akuker/NetworkBreaker/README.md

# NetworkBreaker
Simple USB device for physically breaking/switching Ethernet signals programatically
