akuker/NetworkBreaker/Case/Case.FCStd

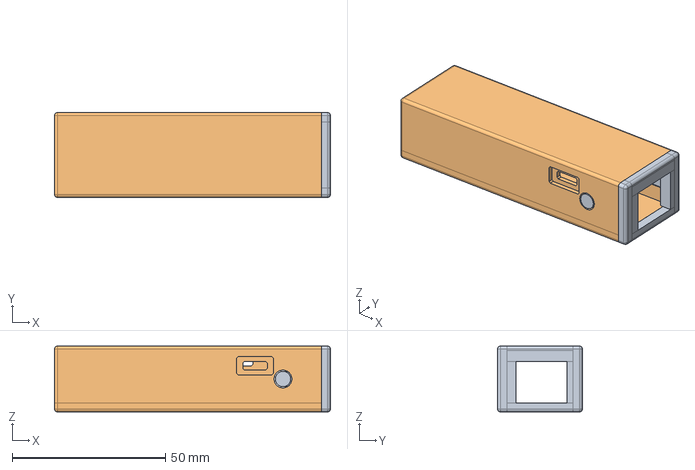
[picture p1: CAD file, 2020-10-17]
Case/Case.FCStd
90.0 x 27.6 x 21.5 mm
