akuker/NetworkBreaker/hw/v1p0/NetworkBreaker_sch.pdf

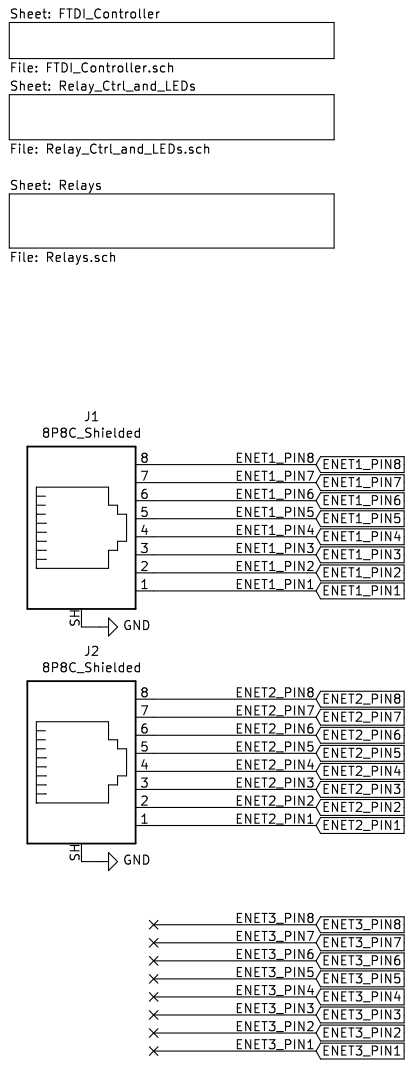
[picture p7: page 1]

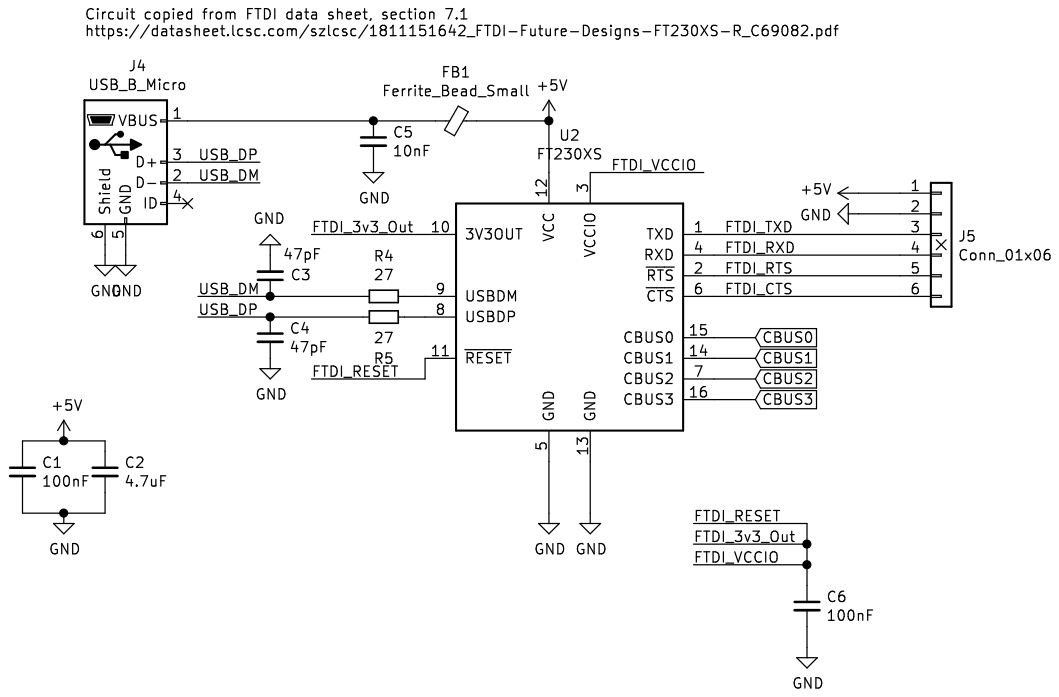
[picture p8: page 2]

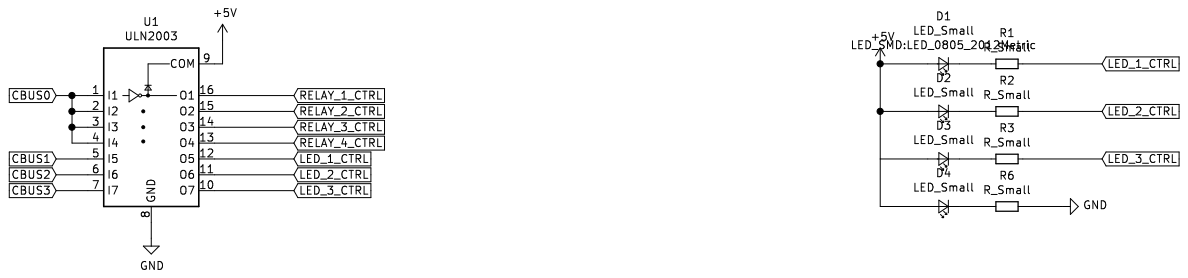
[picture p9: page 3]
