akuker/NetworkBreaker/hw/v1p0/NetworkBreaker.kicad_pcb

## KiCad design hw/v1p0/NetworkBreaker.kicad_pcb (2020-09-26)

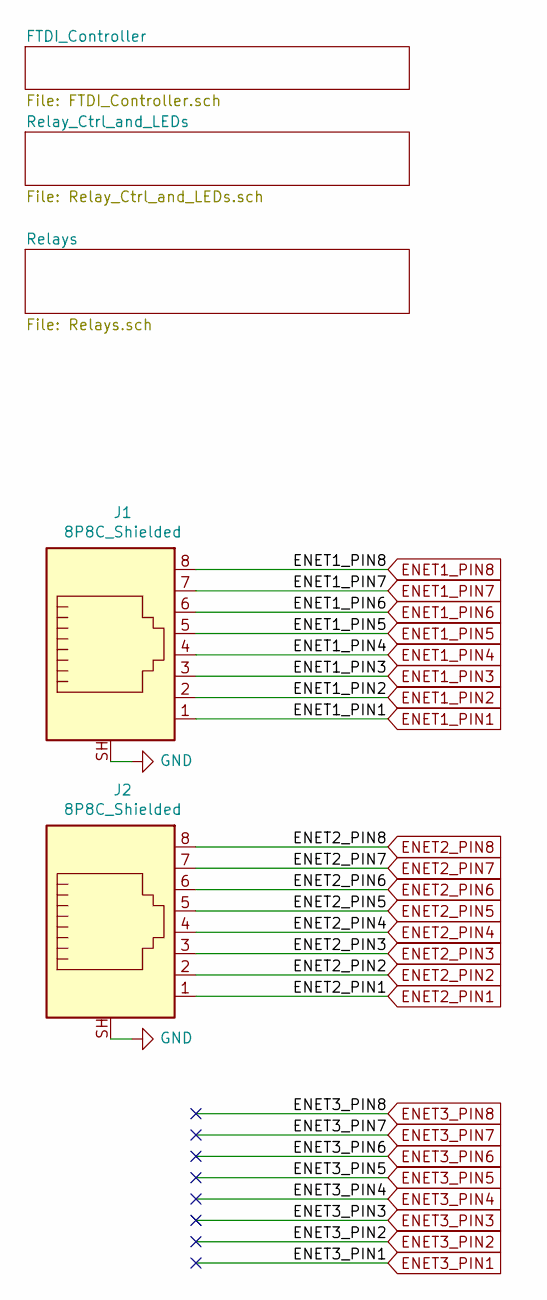
[picture p10: schematic NetworkBreaker.sch]

Parts:
J1, J2: 8P8C_Shielded; RJ45_Amphenol_RJHSE5380; LCSC C86575

Connections:
ENET1_PIN1: J1.1; also elsewhere on the board
ENET1_PIN2: J1.2; also elsewhere on the board
ENET1_PIN3: J1.3; also elsewhere on the board
ENET1_PIN4: J1.4; also elsewhere on the board
ENET1_PIN5: J1.5; also elsewhere on the board
ENET1_PIN6: J1.6; also elsewhere on the board
ENET1_PIN7: J1.7; also elsewhere on the board
ENET1_PIN8: J1.8; also elsewhere on the board
ENET2_PIN1: J2.1; also elsewhere on the board
ENET2_PIN2: J2.2; also elsewhere on the board
ENET2_PIN3: J2.3; also elsewhere on the board
ENET2_PIN4: J2.4; also elsewhere on the board
ENET2_PIN5: J2.5; also elsewhere on the board
ENET2_PIN6: J2.6; also elsewhere on the board
ENET2_PIN7: J2.7; also elsewhere on the board
ENET2_PIN8: J2.8; also elsewhere on the board
GND: J1.SH, J2.SH; also elsewhere on the board

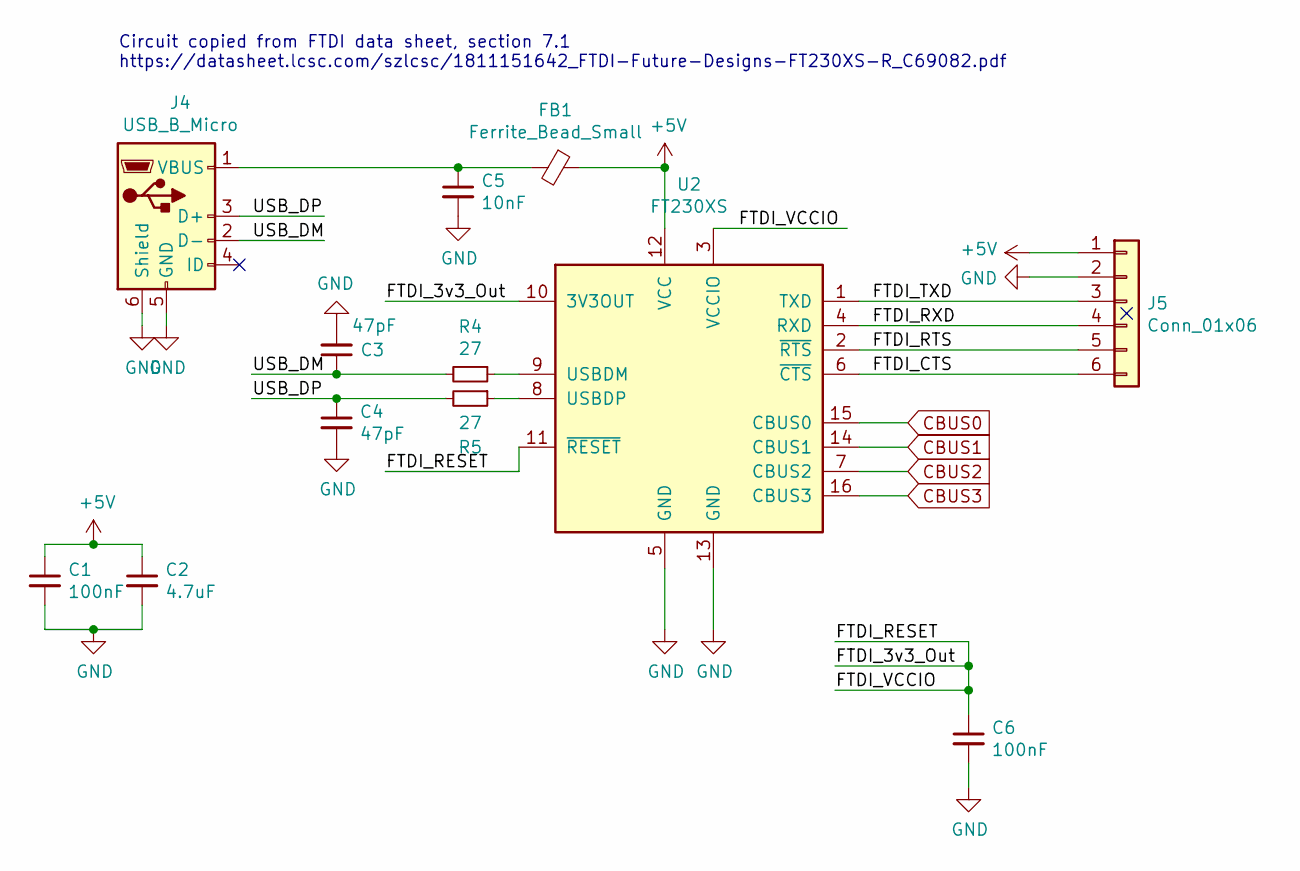
[picture p11: schematic FTDI_Controller.sch]

Parts:
C1, C6: 100nF; C_0805_2012Metric; LCSC C83055
C2: 4.7uF; C_1206_3216Metric; LCSC C123664
C3, C4: 47pF; C_0805_2012Metric; LCSC C123648
C5: 10nF; C_0805_2012Metric; LCSC C83058
FB1: Ferrite_Bead_Small; R_0805_2012Metric_Pad1.15x1.40mm_HandSolder; LCSC C74487
J4: USB_B_Micro; USB_Micro-B_Wuerth_629105150521; LCSC C319170
J5: Conn_01x06; PinHeader_2x03_P1.00mm_Vertical_SMD
R4, R5: 27; R_0805_2012Metric; LCSC C413252
U2: FT230XS; SSOP-16_3.9x4.9mm_P0.635mm; LCSC C69082

Connections:
+5V: C1.1, C2.1, FB1.1, J5.1, U2.12 (VCC); also elsewhere on the board
/FTDI_Controller/FTDI_3v3_Out: C6.1, U2.3 (VCCIO), U2.10 (3V3OUT), U2.11 (~RESET)
/FTDI_Controller/FTDI_CTS: J5.6, U2.6 (~CTS)
/FTDI_Controller/FTDI_RTS: J5.5, U2.2 (~RTS)
/FTDI_Controller/FTDI_RXD: J5.4, U2.4 (RXD)
/FTDI_Controller/FTDI_TXD: J5.3, U2.1 (TXD)
/FTDI_Controller/USB_DM: C3.1, J4.2 (D-), R4.2
/FTDI_Controller/USB_DP: C4.1, J4.3 (D+), R5.2
CBUS0: U2.15 (CBUS0); also elsewhere on the board
CBUS1: U2.14 (CBUS1); also elsewhere on the board
CBUS2: U2.7 (CBUS2); also elsewhere on the board
CBUS3: U2.16 (CBUS3); also elsewhere on the board
GND: C1.2, C2.2, C3.2, C4.2, C5.2, C6.2, J4.5 (GND), J4.6 (Shield), J5.2, U2.5 (GND), U2.13 (GND); also elsewhere on the board
unnamed: C5.1, FB1.2, J4.1 (VBUS)
unnamed: R4.1, U2.9 (USBDM)
unnamed: R5.1, U2.8 (USBDP)

Notes on the sheet:
Circuit copied from FTDI data sheet, section 7.1 https://datasheet.lcsc.com/szlcsc/1811151642_FTDI-Future-Designs-FT230XS-R_C69082.pdf

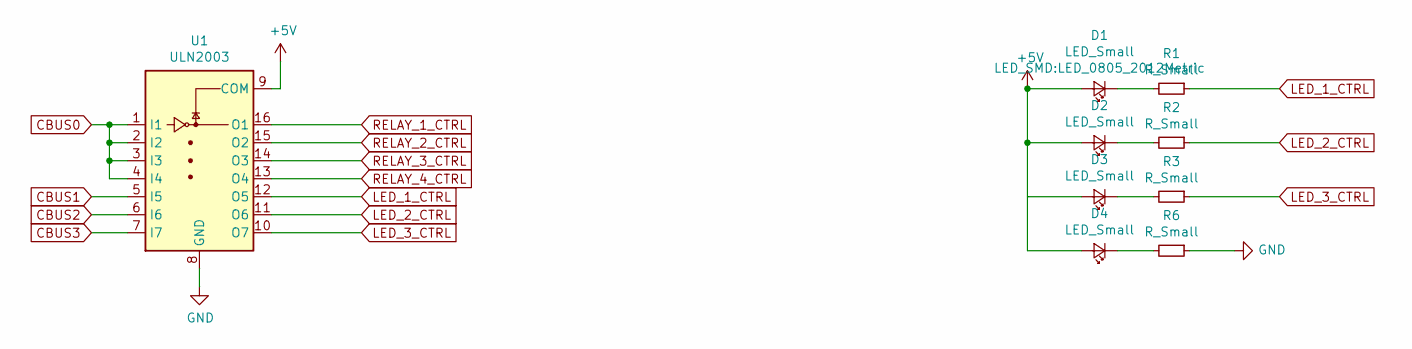
[picture p12: schematic Relay_Ctrl_and_LEDs.sch]

Parts:
D1, D2, D3, D4: LED_Small; LED_0805_2012Metric
R1, R2, R3, R6: R_Small; R_0805_2012Metric
U1: ULN2003; TSSOP-16_4.4x5mm_P0.65mm; LCSC C72751

Connections:
+5V: D1.2 (A), D2.2 (A), D3.2 (A), D4.2 (A), U1.9 (COM); also elsewhere on the board
CBUS0: U1.1 (I1), U1.2 (I2), U1.3 (I3), U1.4 (I4); also elsewhere on the board
CBUS1: U1.5 (I5); also elsewhere on the board
CBUS2: U1.6 (I6); also elsewhere on the board
CBUS3: U1.7 (I7); also elsewhere on the board
GND: R6.1, U1.8 (GND); also elsewhere on the board
LED_1_CTRL: R1.1, U1.12 (O5)
LED_2_CTRL: R2.1, U1.11 (O6)
LED_3_CTRL: R3.1, U1.10 (O7)
unnamed: D1.1 (K), R1.2
unnamed: D2.1 (K), R2.2
unnamed: D3.1 (K), R3.2
unnamed: D4.1 (K), R6.2
RELAY_1_CTRL: U1.16 (O1); also elsewhere on the board
RELAY_2_CTRL: U1.15 (O2); also elsewhere on the board
RELAY_3_CTRL: U1.14 (O3); also elsewhere on the board
RELAY_4_CTRL: U1.13 (O4); also elsewhere on the board

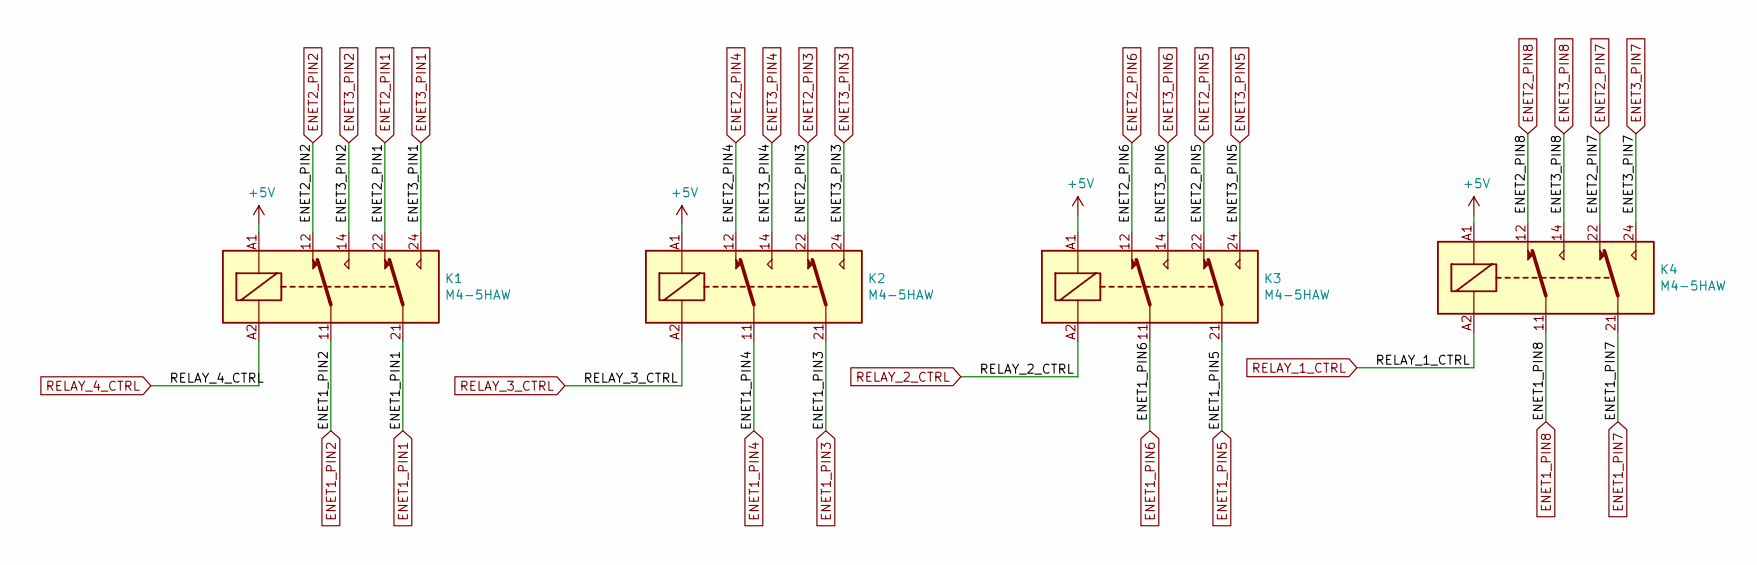
[picture p13: schematic Relays.sch]

Parts:
K1, K2, K3, K4: M4-5HAW; Relay_DPDT_Finder_30.22; LCSC C165868

Connections:
+5V: K1.A1, K2.A1, K3.A1, K4.A1; also elsewhere on the board
ENET1_PIN1: K1.21; also elsewhere on the board
ENET1_PIN2: K1.11; also elsewhere on the board
ENET1_PIN3: K2.21; also elsewhere on the board
ENET1_PIN4: K2.11; also elsewhere on the board
ENET1_PIN5: K3.21; also elsewhere on the board
ENET1_PIN6: K3.11; also elsewhere on the board
ENET1_PIN7: K4.21; also elsewhere on the board
ENET1_PIN8: K4.11; also elsewhere on the board
ENET2_PIN1: K1.22; also elsewhere on the board
ENET2_PIN2: K1.12; also elsewhere on the board
ENET2_PIN3: K2.22; also elsewhere on the board
ENET2_PIN4: K2.12; also elsewhere on the board
ENET2_PIN5: K3.22; also elsewhere on the board
ENET2_PIN6: K3.12; also elsewhere on the board
ENET2_PIN7: K4.22; also elsewhere on the board
ENET2_PIN8: K4.12; also elsewhere on the board
ENET3_PIN1: K1.24
ENET3_PIN2: K1.14
ENET3_PIN3: K2.24
ENET3_PIN4: K2.14
ENET3_PIN5: K3.24
ENET3_PIN6: K3.14
ENET3_PIN7: K4.24
ENET3_PIN8: K4.14
RELAY_1_CTRL: K4.A2; also elsewhere on the board
RELAY_2_CTRL: K3.A2; also elsewhere on the board
RELAY_3_CTRL: K2.A2; also elsewhere on the board
RELAY_4_CTRL: K1.A2; also elsewhere on the board

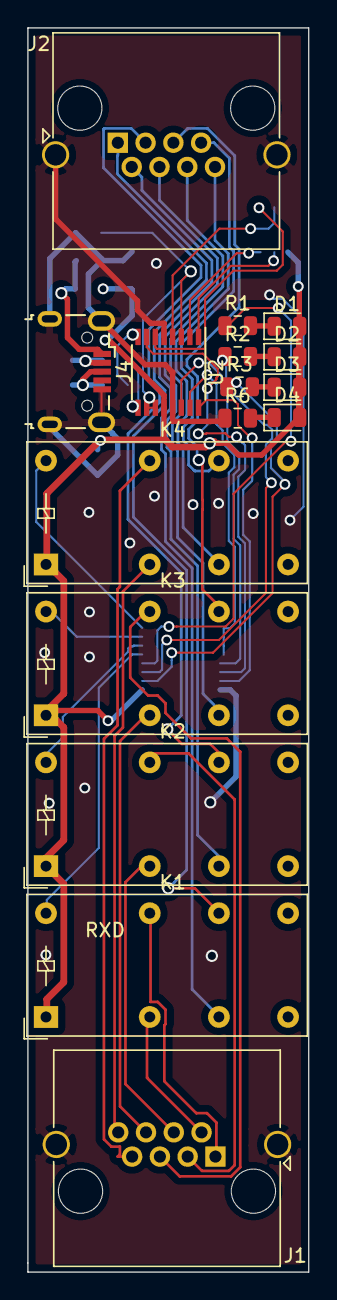
[picture p14: board hw/v1p0/NetworkBreaker.kicad_pcb from above]

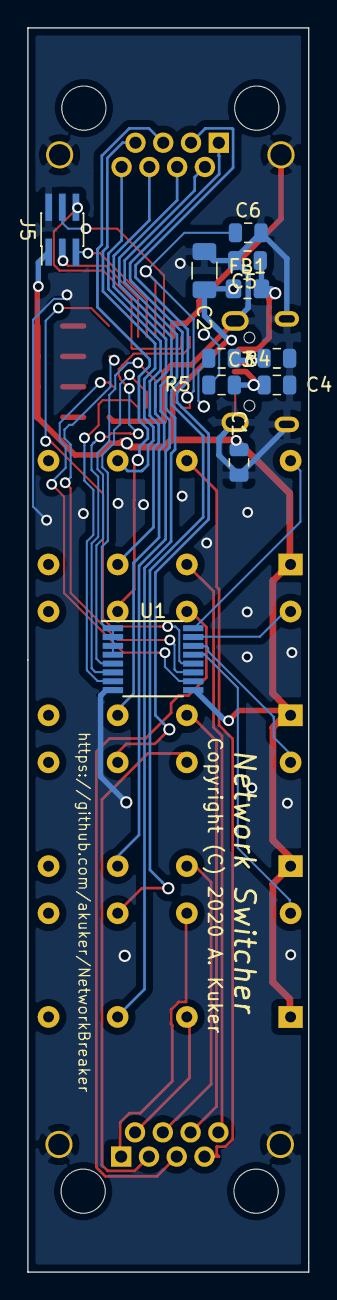
[picture p15: board hw/v1p0/NetworkBreaker.kicad_pcb from below]

Board: 2 copper layers, 20.6 x 91.4 mm, 27 parts (11 on the bottom side), 43 nets.
