akuker/NetworkBreaker/hw/v0p1/NetworkBreaker.kicad_pcb

## KiCad design hw/v0p1/NetworkBreaker.kicad_pcb (2020-09-07)

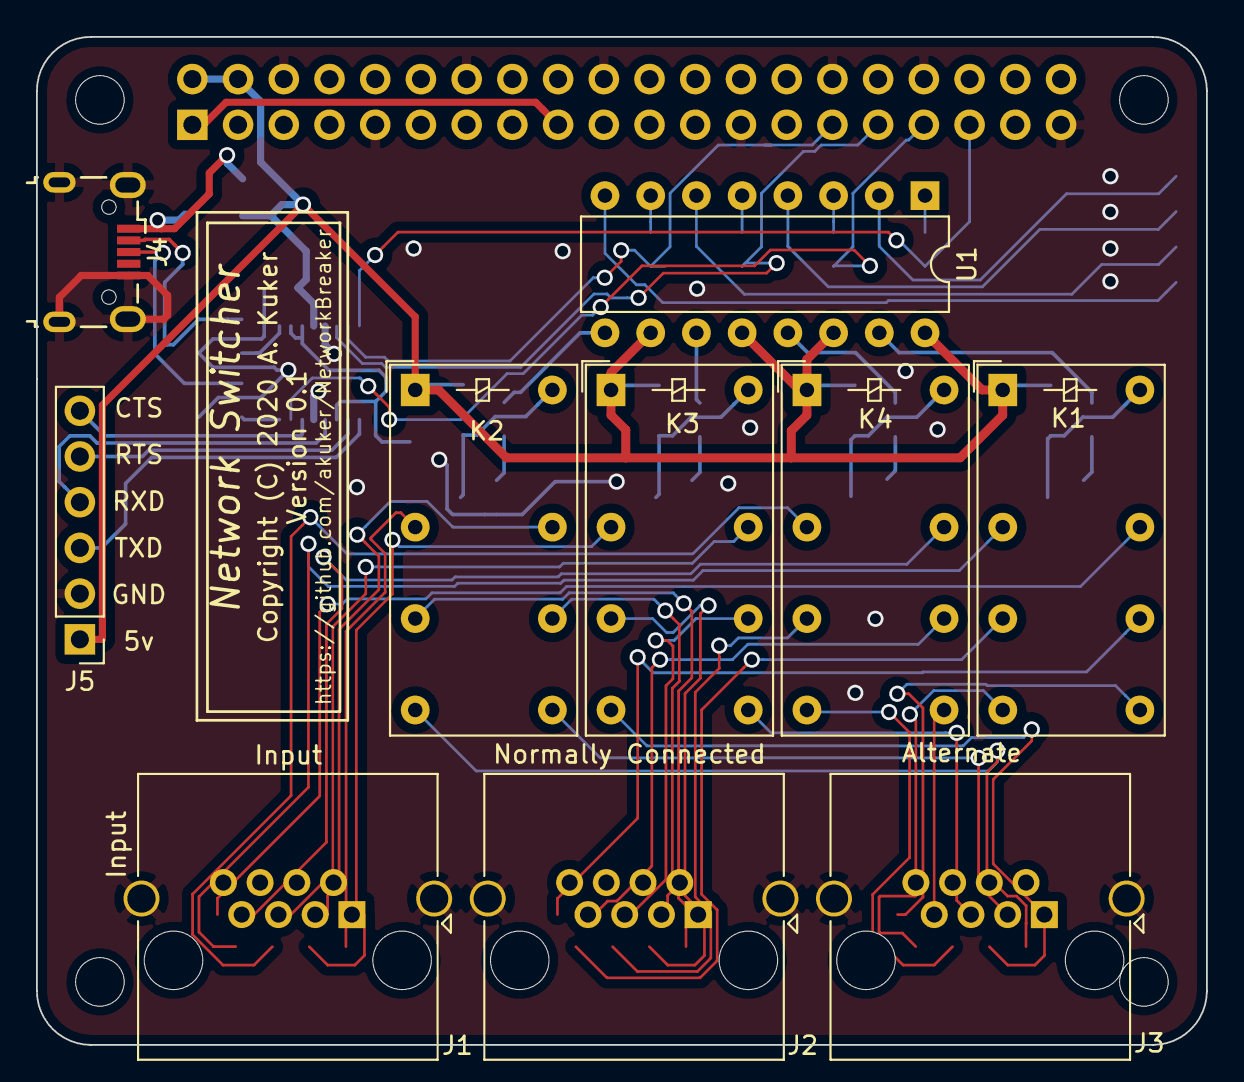
[picture p16: board hw/v0p1/NetworkBreaker.kicad_pcb from above]

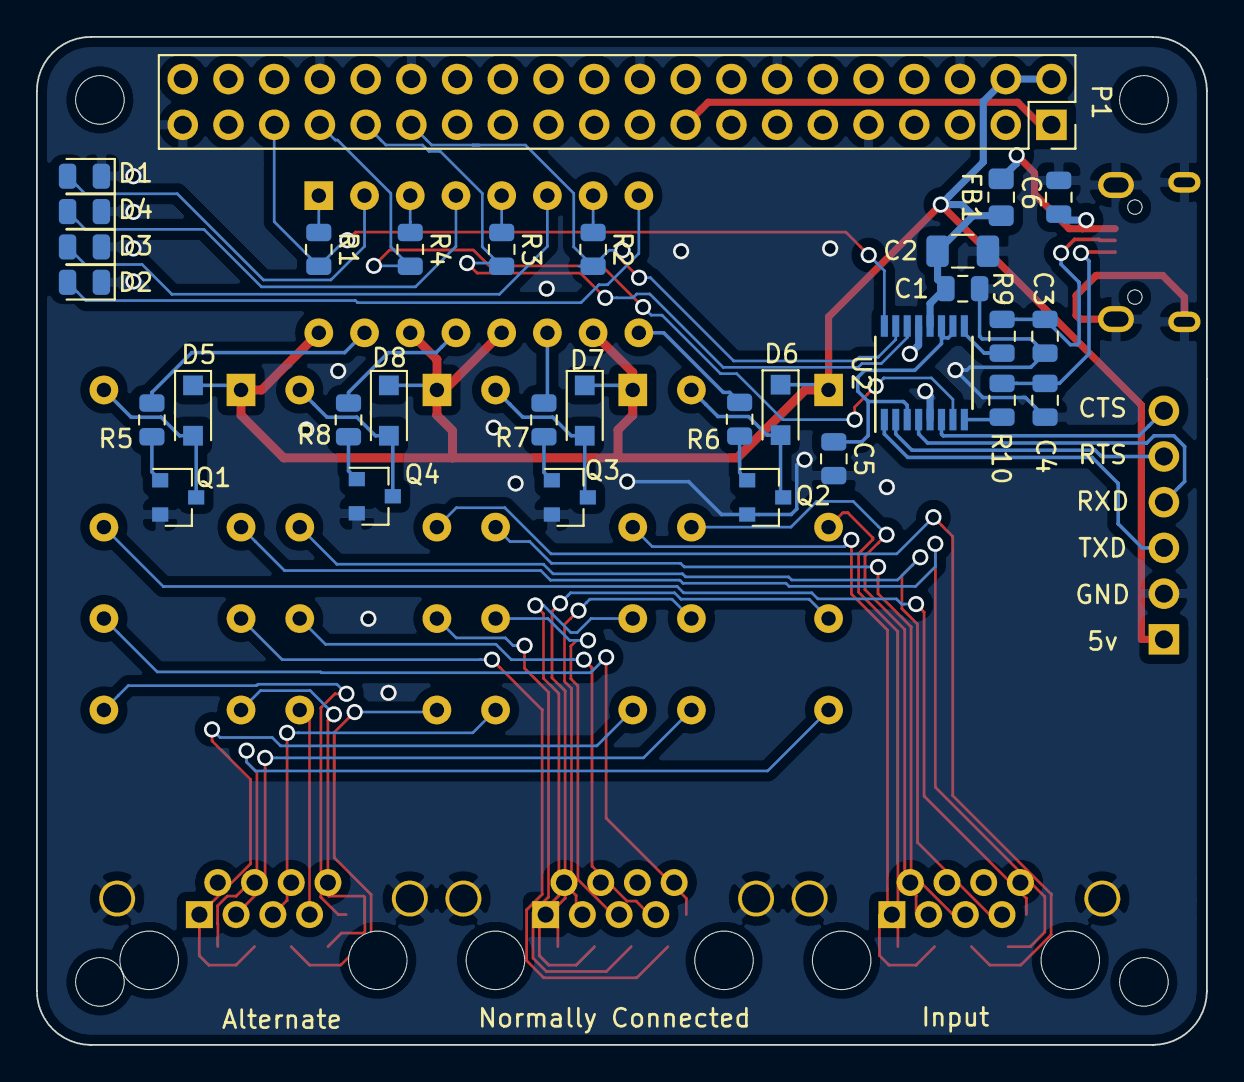
[picture p17: board hw/v0p1/NetworkBreaker.kicad_pcb from below]

Board: 2 copper layers, 65.0 x 56.0 mm, 45 parts (31 on the bottom side), 61 nets.

Parts:
C1, C5: 100nF; C_0805_2012Metric
C2: 4.7uF; C_1206_3216Metric
C3, C4: 47pF; C_0805_2012Metric
C6: 10nF; C_0805_2012Metric
D1, D2, D3, D4: Green; LED_0805_2012Metric
D5, D6, D7, D8: D_Small; D_SOD-123F
FB1: Ferrite_Bead_Small; R_0805_2012Metric_Pad1.15x1.40mm_HandSolder
J1, J2, J3: 8P8C_Shielded; RJ45_Amphenol_RJHSE5380
J4: USB_B_Micro; USB_Micro-B_Wuerth_629105150521
J5: Conn_01x06; PinHeader_1x06_P2.54mm_Vertical
K1, K2, K3, K4: M4-5HAW; Relay_DPDT_Finder_30.22
MK1, MK2, MK3, MK4: M2.5; MountingHole_2.7mm_M2.5
P1: Conn_02x20_Odd_Even; PinSocket_2x20_P2.54mm_Vertical
Q1, Q2, Q3, Q4: 2N3904; SOT-23
R1, R2, R3, R4: 220; R_0805_2012Metric
R5, R6, R7, R8: 10k; R_0805_2012Metric
R9, R10: 27; R_0805_2012Metric
U1: TLP627-4; DIP-16_W7.62mm
U2: FT230XS; SSOP-16_3.9x4.9mm_P0.635mm

Connections:
+3V3: P1.1, P1.17
+5V: C1.1, C2.1, D5.1, D6.1, D7.1, D8.1, FB1.1, J5.1, K1.A1, K2.A1, K3.A1, K4.A1, P1.2, P1.4, U1.10, U1.12, U1.14, U1.16, U2.12
/ENET1_PIN1: J1.1, K1.21
/ENET1_PIN2: J1.2, K1.11
/ENET1_PIN3: J1.3, K4.21
/ENET1_PIN4: J1.4, K4.11
/ENET1_PIN5: J1.5, K3.21
/ENET1_PIN6: J1.6, K3.11
/ENET1_PIN7: J1.7, K2.21
/ENET1_PIN8: J1.8, K2.11
/ENET2_PIN1: J2.1, K1.22
/ENET2_PIN2: J2.2, K1.12
/ENET2_PIN3: J2.3, K4.22
/ENET2_PIN4: J2.4, K4.12
/ENET2_PIN5: J2.5, K3.22
/ENET2_PIN6: J2.6, K3.12
/ENET2_PIN7: J2.7, K2.22
/ENET2_PIN8: J2.8, K2.12
/ENET3_PIN1: J3.1, K1.24
/ENET3_PIN2: J3.2, K1.14
/ENET3_PIN3: J3.3, K4.24
/ENET3_PIN4: J3.4, K4.14
/ENET3_PIN5: J3.5, K3.24
/ENET3_PIN6: J3.6, K3.14
/ENET3_PIN7: J3.7, K2.24
/ENET3_PIN8: J3.8, K2.14
/FTDI_Controller/FTDI_3v3_Out: C5.1, U2.3, U2.10, U2.11
/FTDI_Controller/FTDI_CTS: J5.6, U2.6
/FTDI_Controller/FTDI_RTS: J5.5, U2.2
/FTDI_Controller/FTDI_RXD: J5.4, U2.4
/FTDI_Controller/FTDI_TXD: J5.3, U2.1
/FTDI_Controller/USB_DM: C3.1, J4.2, R9.2
/FTDI_Controller/USB_DP: C4.1, J4.3, R10.2
GND: C1.2, C2.2, C3.2, C4.2, C5.2, C6.2, D1.1, D2.1, D3.1, D4.1, J1.SH, J2.SH, J3.SH, J4.5, J4.6, J5.2, P1.6, P1.9, P1.14, P1.20, P1.25, P1.30, P1.34, P1.39, Q1.2, Q2.2, Q3.2, Q4.2, U2.5, U2.13
GPIO5: P1.29, R2.2, U2.15
GPIO6: P1.31, R3.2, U2.14
GPIO13: P1.33, R4.2, U2.7
GPIO19: P1.35, R1.2, U2.16
unnamed: C6.1, FB1.2, J4.1
unnamed: D1.2, U1.2
unnamed: D2.2, U1.8
unnamed: D3.2, U1.6
unnamed: D4.2, U1.4
unnamed: D5.2, K1.A2, Q1.3
unnamed: D6.2, K2.A2, Q2.3
unnamed: D7.2, K3.A2, Q3.3
unnamed: D8.2, K4.A2, Q4.3
unnamed: Q1.1, R5.1
unnamed: Q2.1, R6.1
unnamed: Q3.1, R7.1
unnamed: Q4.1, R8.1
unnamed: R1.1, U1.1
unnamed: R2.1, U1.7
unnamed: R3.1, U1.5
unnamed: R4.1, U1.3
unnamed: R5.2, U1.15
unnamed: R6.2, U1.9
unnamed: R7.2, U1.11
unnamed: R8.2, U1.13
unnamed: R9.1, U2.9
unnamed: R10.1, U2.8
