akuker/NetworkBreaker/(commit log)

2020-08-22 First version of network breaker
    [Arduino_Controller.sch, FTDI_Controller.sch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]
2020-08-22 Updated BOM
    [FTDI_Controller.sch, NetworkBreaker.kicad_pcb, NetworkBreaker.sch, RPi_Connector.sch]
2020-08-23 Updated part LCSC part numbers
    [NetworkBreaker-B_Cu.gbl, NetworkBreaker-B_Mask.gbs, NetworkBreaker-B_SilkS.gbo, NetworkBreaker-Edge_Cuts.gm1, NetworkBreaker-F_Cu.gtl, NetworkBreaker-F_Mask.gts, NetworkBreaker-F_SilkS.gto, NetworkBreaker.drl]
2020-09-07 Initial round of corrections from v0.1
    [Arduino_Controller.sch, FTDI_Controller.sch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]
2020-09-12 Version 1.0 of breaker only
    [Arduino_Controller.sch, FTDI_Controller.sch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]
