akuker/NetworkBreaker/(notices)

Notices in the files:
hw/v0p1/NetworkBreaker.kicad_pcb:
Copyright (C) 2020 A. Kuker
